UtBotsAtHome-UTFPR/bms_hestia/README.md

# BMSi-Hardware
Contains the hardware design of the BMSi board.

This is a work in progress, as development still being done.
No guarantee for functionality or safety! this design is experimental and tests are still being done.
The firmware is available in the main [BMSi](https://github.com/MrSerafim/BMSi) git.

This project requires soldering of many fine pitched parts including QFN.

### LICENSE NOTE: The root license applies to all subfolders NOT containing their own LICENSE file. If a subfolder contains a different LICENSE file this different license applies to all subfolders below this LICENSE file.

**If you want to sell any hardware of this project yourself i would kindly ask you to get in contact with me ([mail](mailto:luissouzaserafim@gmail.com))**
