UtBotsAtHome-UTFPR/bms_hestia/BMSi-Main/V2/README.md

### BMSi V2 board
This was the first released and working board.
