UtBotsAtHome-UTFPR/bms_hestia/BMSi-Main/V2/Board.png

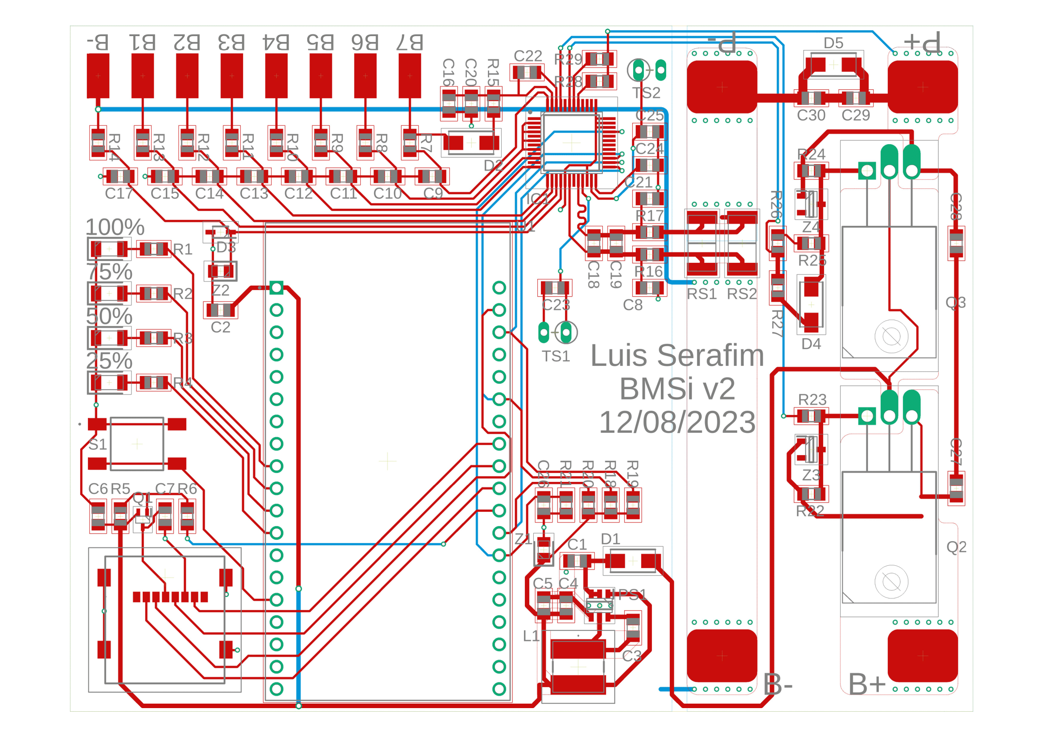
BMSi-Main/V2/Board.png
