UtBotsAtHome-UTFPR/bms_hestia/BMSi-Main/V2/BOM.xlsx

Sheet: BMSiv2
PRICE | Qty | TOTAL | Value | Package | Parts | Description | MANUFACTURER_NAME | MOUSER_PART_NUMBER | MOUSER_PRICE-STOCK
€0.021 | 8 | 0.17 € | 1/4W 20 OHM 1% | R0805 | R7, R8, R9, R10, R11, R12, R13, R14 | RESISTOR, European symbol |  |  | https://pt.mouser.com/ProductDetail/KOA-Speer/RK73H2ATTD20R0F?qs=sPP%252BYRfrDLyF2CjhOoVciw%3D%3D
€0.021 | 8 | 0.17 € | 1/4W 100 Ohms 1% | R0805 | R1, R2, R3, R4, R6, R15, R16, R17 | RESISTOR, European symbol |  |  | https://pt.mouser.com/ProductDetail/KOA-Speer/RK73H2ATTD1000F?qs=sfWGJbSe6PrSPN%2FbSWq5Cw%3D%3D
€0.021 | 4 | 0.08 € | 1/4W 5.1 kOhms 1% | R0805 | R23, R25, R26, R27 | RESISTOR, European symbol |  |  | https://pt.mouser.com/ProductDetail/KOA-Speer/RK73H2ATTD5101F?qs=qdbN2r920CXERR4aJasjig%3D%3D
€0.035 | 7 | 0.25 € | 1/4W 10 kOhms 1% | R0805 | R5, R18, R19, R20, R21, R28, R29 | RESISTOR, European symbol |  |  | https://pt.mouser.com/ProductDetail/KOA-Speer/RK73H2ATTDD1002F?qs=MxBfFmQCbB%252BkcQT2CtAwhQ%3D%3D
€0.035 | 2 | 0.07 € | 1/4W 10 Mohms 1% | R0805 | R22, R24 | RESISTOR, European symbol |  |  | https://pt.mouser.com/ProductDetail/KOA-Speer/RK73H2ATTDD1005F?qs=b4HQPcG6p0mmJwIGRp2kJQ%3D%3D
€0.055 | 2 | 0.11 € | 100 pF 10% 50V | C0805 | C18, C20 | CAPACITOR, European symbol | Kemet |  | https://pt.mouser.com/ProductDetail/KEMET/C0805C101K5GAC?qs=Zjfhvh7dXTMjTuwbhEzY2Q%3D%3D
€0.034 | 2 | 0.07 € | 470 pF 10% 50V | C0805 | C23, C25 | CAPACITOR, European symbol | Kemet |  | https://pt.mouser.com/ProductDetail/KEMET/C0805C471K5RACTU?qs=zLJ08xwufm6Yml9V9rLpFw%3D%3D
€0.023 | 10 | 0.23 € | 100 nF 10% 50V | C0805 | C3, C7, C8, C19, C21, C26, C27, C28, C29, C30 | CAPACITOR, European symbol | Kemet |  | https://pt.mouser.com/ProductDetail/Samsung-Electro-Mechanics/CL21B104KBCNFNC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
€0.032 | 8 | 0.26 € | 220 nF 10% 50V | C0805 | C9, C10, C11, C12, C13, C14, C15, C17 | CAPACITOR, European symbol | Kemet |  | https://pt.mouser.com/ProductDetail/Samsung-Electro-Mechanics/CL21B224KBFNFNE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
€0.055 | 1 | 0.06 € | 470 nF 10% 50V | C0805 | C22 | CAPACITOR, European symbol | Kemet |  | https://pt.mouser.com/ProductDetail/Samsung-Electro-Mechanics/CL21B474KBFNNNF?qs=yOVawPpwOwkFyCrUQsgTUg%3D%3D
€0.072 | 2 | 0.14 € | 1 uF 10% 50V | C0805 | C2, C16 | CAPACITOR, European symbol | Kemet |  | https://pt.mouser.com/ProductDetail/Samsung-Electro-Mechanics/CL21B105KBFNNNF?qs=349EhDEZ59rjtiyPmgVOOA%3D%3D
€0.145 | 1 | 0.14 € | 2.2 uF 10% 50V | C0805 | C24 | CAPACITOR, European symbol | Kemet |  | https://pt.mouser.com/ProductDetail/Samsung-Electro-Mechanics/CL21B225KBYNNNE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
€0.265 | 2 | 0.53 € | 10 uF 10% 50V | C0805 | C1, C6 | CAPACITOR, European symbol | Samsung |  | https://pt.mouser.com/ProductDetail/Samsung-Electro-Mechanics/CL21A106KBYQNNE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
€0.143 | 2 | 0.29 € | 22 uF 10% 16V | C0805 | C4, C5 | CAPACITOR, American symbol | Samsung |  | https://pt.mouser.com/ProductDetail/Samsung-Electro-Mechanics/CL21A226KOQNNNE?qs=AQlKX63v8RtLP39pX3WzzA%3D%3D
€0.801 | 1 | 0.80 € | AP63203WU-7 | SOT95P280X100-6N | PS1 | Switching Voltage Regulators DCDC Conv HV Buck TSOT26 T&R 3K | Diodes Inc. | 621-AP63203WU-7 | https://pt.mouser.com/ProductDetail/621-AP63203WU-7
€0.325 | 4 | 1.30 € | APT3216LVBC_D | LEDC3216X95N | LED1, LED2, LED3, LED4 | Standard LEDs - SMD 3.2X1.6MM LOW CRNT | Kingbright | 604-APT3216LVBCD | https://pt.mouser.com/ProductDetail/604-APT3216LVBCD
€0.306 | 1 | 0.31 € | BAT43WS-E3-08 | SOD2713X115N | D3 | Schottky Diodes & Rectifiers 30Volt 200mA 4A IFSM | Vishay | 78-BAT43WS-E3-08 | https://pt.mouser.com/ProductDetail/Vishay-Semiconductors/BAT43WS-E3-08?qs=KP8Io%2FXyE5T4LlUmkdvIAg%3D%3D
€0.144 | 2 | 0.29 € | BZX84-C16,215 | SOT95P230X110-3N | Z3, Z4 | Zener Diode 16 V 250 mW +/-5% Surface Mount TO-236AB | Nexperia | 771-BZX84-C16-T/R | https://pt.mouser.com/ProductDetail/771-BZX84-C16-T-R
€0.297 | 2 | 0.59 € | BZY55B3V6_RBG | DIOC2012X85N | Z1, Z2 | Zener Diodes 0805 500mW 2% Small Signal Zener Diode | Taiwan Semiconductor | 821-BZY55B3V6RBG | https://pt.mouser.com/ProductDetail/Taiwan-Semiconductor/BZY55B3V6-RBG?qs=mAH9sUMRCtv1hjtg7HbTxw%3D%3D
€0.189 | 4 | 0.76 € | S1B-13-F | DIONM5126X230N | D1, D2, D4, D5 | Diodes Inc S1B-13-F Switching Diode, 1A 100V, 2-Pin SMA | Diodes Inc. | 621-S1B-F | https://pt.mouser.com/ProductDetail/Diodes-Incorporated/S1B-13-F?qs=zxTnCqfIubBIimUkgF4o7A%3D%3D
€0.270 | 1 | 0.27 € | DMG1013T-7 | SOT50P160X90-3N | Q1 | MOSFET P-Channel 20V 0.46A SOT523 Diodes Inc DMG1013T-7 P-channel MOSFET Transistor, -0.46 A, -20 V, 3-Pin SOT-523 | Diodes Inc. | 621-DMG1013T-7 | https://pt.mouser.com/ProductDetail/621-DMG1013T-7
€1.640 | 2 | 3.28 € | IRFB3207PBF | TO220_HORIZONTAL | Q2, Q3 | MOSFET MOSFT 75V 180A 4.5mOhm 180nC |  |  | https://pt.mouser.com/ProductDetail/942-IRFB3207PBF
€0.567 | 2 | 1.13 € | PA2512FKE7W0R016E | RESC6432X88N | RS1, RS2 | 16 mOhms +/-1% 2W Chip Resistor 2512 (6432 Metric) Anti-Sulfur, Automotive AEC-Q200, Current Sense, Moisture Resistant Metal Element | YAGEO |  | https://pt.mouser.com/ProductDetail/603-PA2512FKE7W0R16E
€4.440 | 1 | 4.44 € | BQ76942PFBR | QFP50P900X900X120-48N | IC1 | Battery Management 3-series to 10-series multicell battery monitor and protector | Texas Instruments | 595-BQ76942PFBR | https://pt.mouser.com/ProductDetail/Texas-Instruments/BQ76942PFBR?qs=IS%252B4QmGtzzpmepW6RmrD8g%3D%3D
€1.040 | 1 | 1.04 € | MEM2067-02-180-00-A | MEM20670218000A | J1 | GCT (GLOBAL CONNECTOR TECHNOLOGY) - MEM2067-02-180-00-A - Memory Socket, MEM2067 Series, Memory Card, 8 Contacts, Copper Alloy, Gold Plated Contacts | GCT (GLOBAL CONNECTOR TECHNOLOGY) | 640-MEM20670218000A | https://pt.mouser.com/ProductDetail/640-MEM20670218000A
€0.288 | 1 | 0.29 € | FSM2JSMAATR | FSM2J_1 | S1 | Tactile switch,SMT,SPST | TE Connectivity | 506-FSM2JSMAATR | https://pt.mouser.com/ProductDetail/506-FSM2JSMAATR
€0.351 | 1 | 0.35 € | SRR5018-3R9Y | SRR50183R9Y | L1 | Power Inductors - SMD 3.9uH 30% SMD 5018 | Bourns | 652-SRR5018-3R9Y | https://pt.mouser.com/ProductDetail/652-SRR5018-3R9Y
€0.966 | 2 | 1.93 € | 103AT-2 | RS-2,5 | TS1, TS2 | THERMISTOR 103AT-2 10kOhm |  |  | https://pt.mouser.com/ProductDetail/954-103AT-2
€9.110 | 1 | 9.11 € | ESP32-DEVKITC-32D | ESP32-DEVKITC-32D | U1 | Esp32
Subtotal |  | 28.45 €
 |  | 1.59 € | PCB JLCPCB
Total |  | 30.04 €
Price values updated 12/08/2023

Sheet: Table
Componentes | Custo Unit. (€/Unid.) | Quant. (Unid.) | Preço (€) | Componentes | Custo Unit. (€/Unid.) | Quant. (Unid.) | Preço (€)
Resistores precisão SMD | 0.03 | 29 | 0.74 | ESP32-DEVKITC-32D | 9.11 | 1 | 9.11
Resistor Shunt 16 mOhm | 0.57 | 2 | 1.13 | Monitor Bateria - BQ76942 | 4.44 | 1 | 4.44
Capacitores cerâmicos SMD | 0.06 | 30 | 1.82 | MOSFET N - IRFB3207 | 1.64 | 2 | 3.28
Indutor 3.9uH SMD | 0.35 | 1 | 0.35 | MOSFET P - DMG1013T | 0.27 | 1 | 0.27
Thermistor 103AT-2 | 0.97 | 2 | 1.93 | Buck DC/DC - AP63203 | 0.80 | 1 | 0.80
Diodos SMD | 0.22 | 9 | 1.94 | Soquete microSD | 1.04 | 1 | 1.04
LEDs SMD | 0.33 | 4 | 1.30 | Botão Tactil SMD | 0.29 | 1 | 0.29
Fabricação PCB | 1.59 | 1 | 1.59
Total |  |  |  |  |  |  | 30.04
