UtBotsAtHome-UTFPR/bms_hestia/BMSi-Main/V2/Schematic.pdf

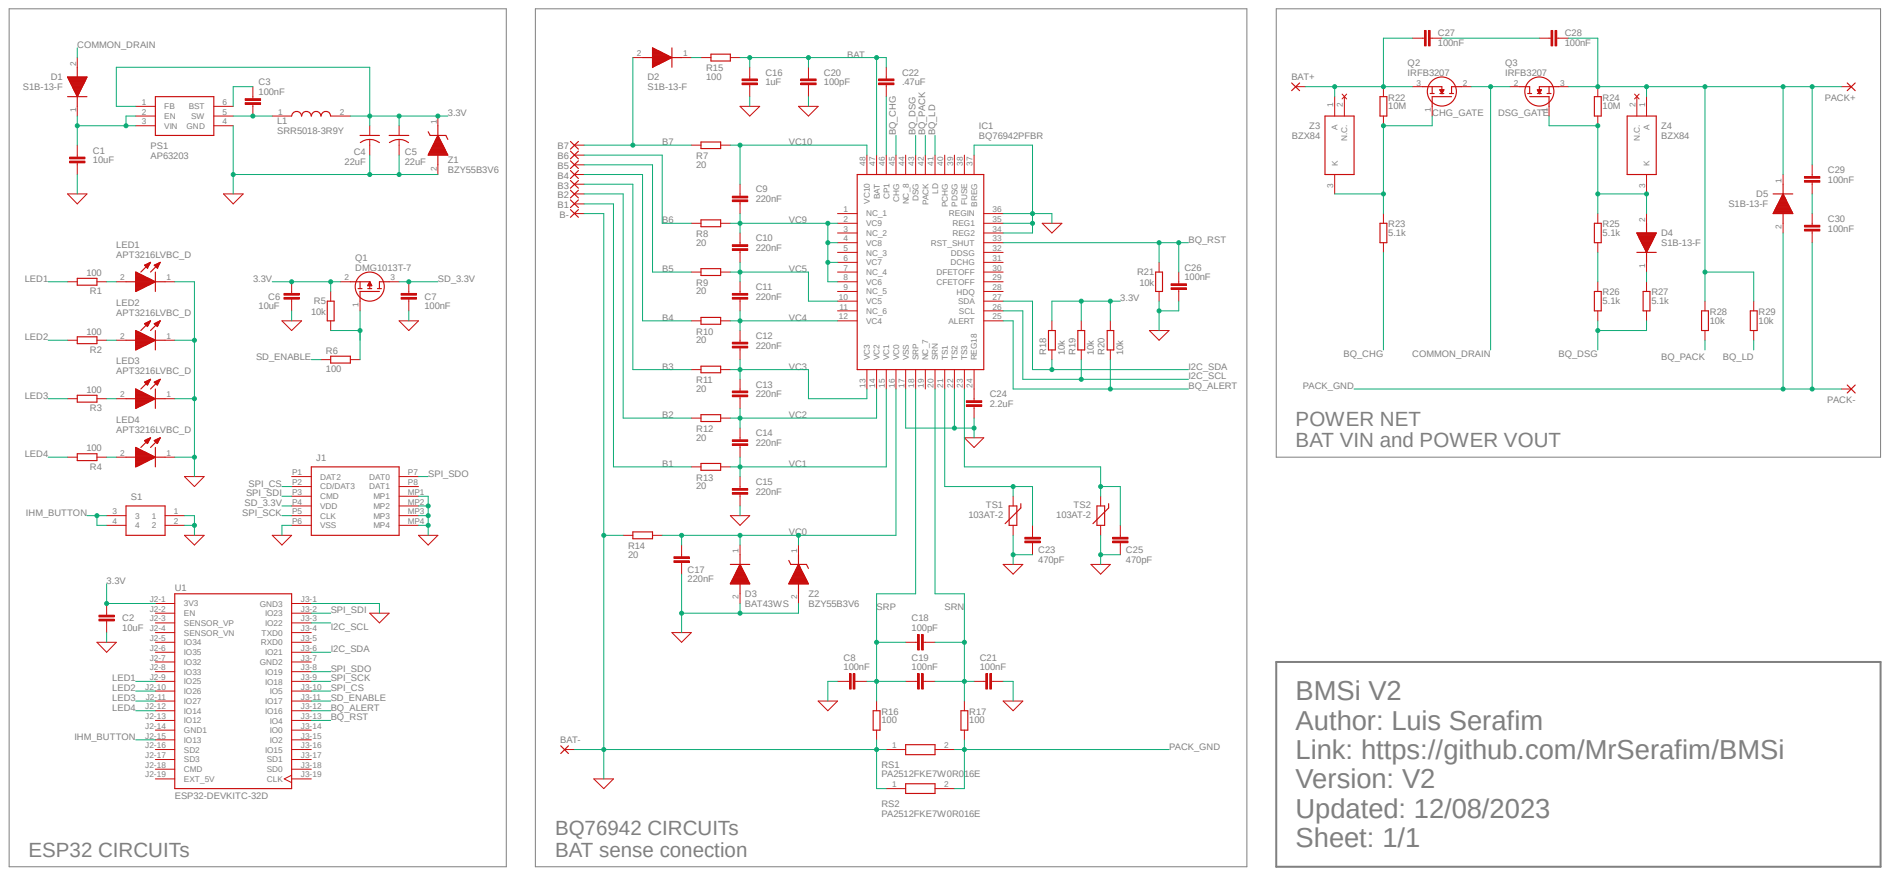
[picture p2: page 1]

PACK_GND
POWER NET
BAT VIN and POWER VOUT

BMSi V2
Author: Luis Serafim
Link: https://github.com/MrSerafim/BMSi
Version: V2
Updated: 12/08/2023
Sheet: 1/1
