UtBotsAtHome-UTFPR/bms_hestia/BMSi-Main/V2/SmartBMSv2.brd

## EAGLE design BMSi-Main/V2/SmartBMSv2.brd (2025-05-13)

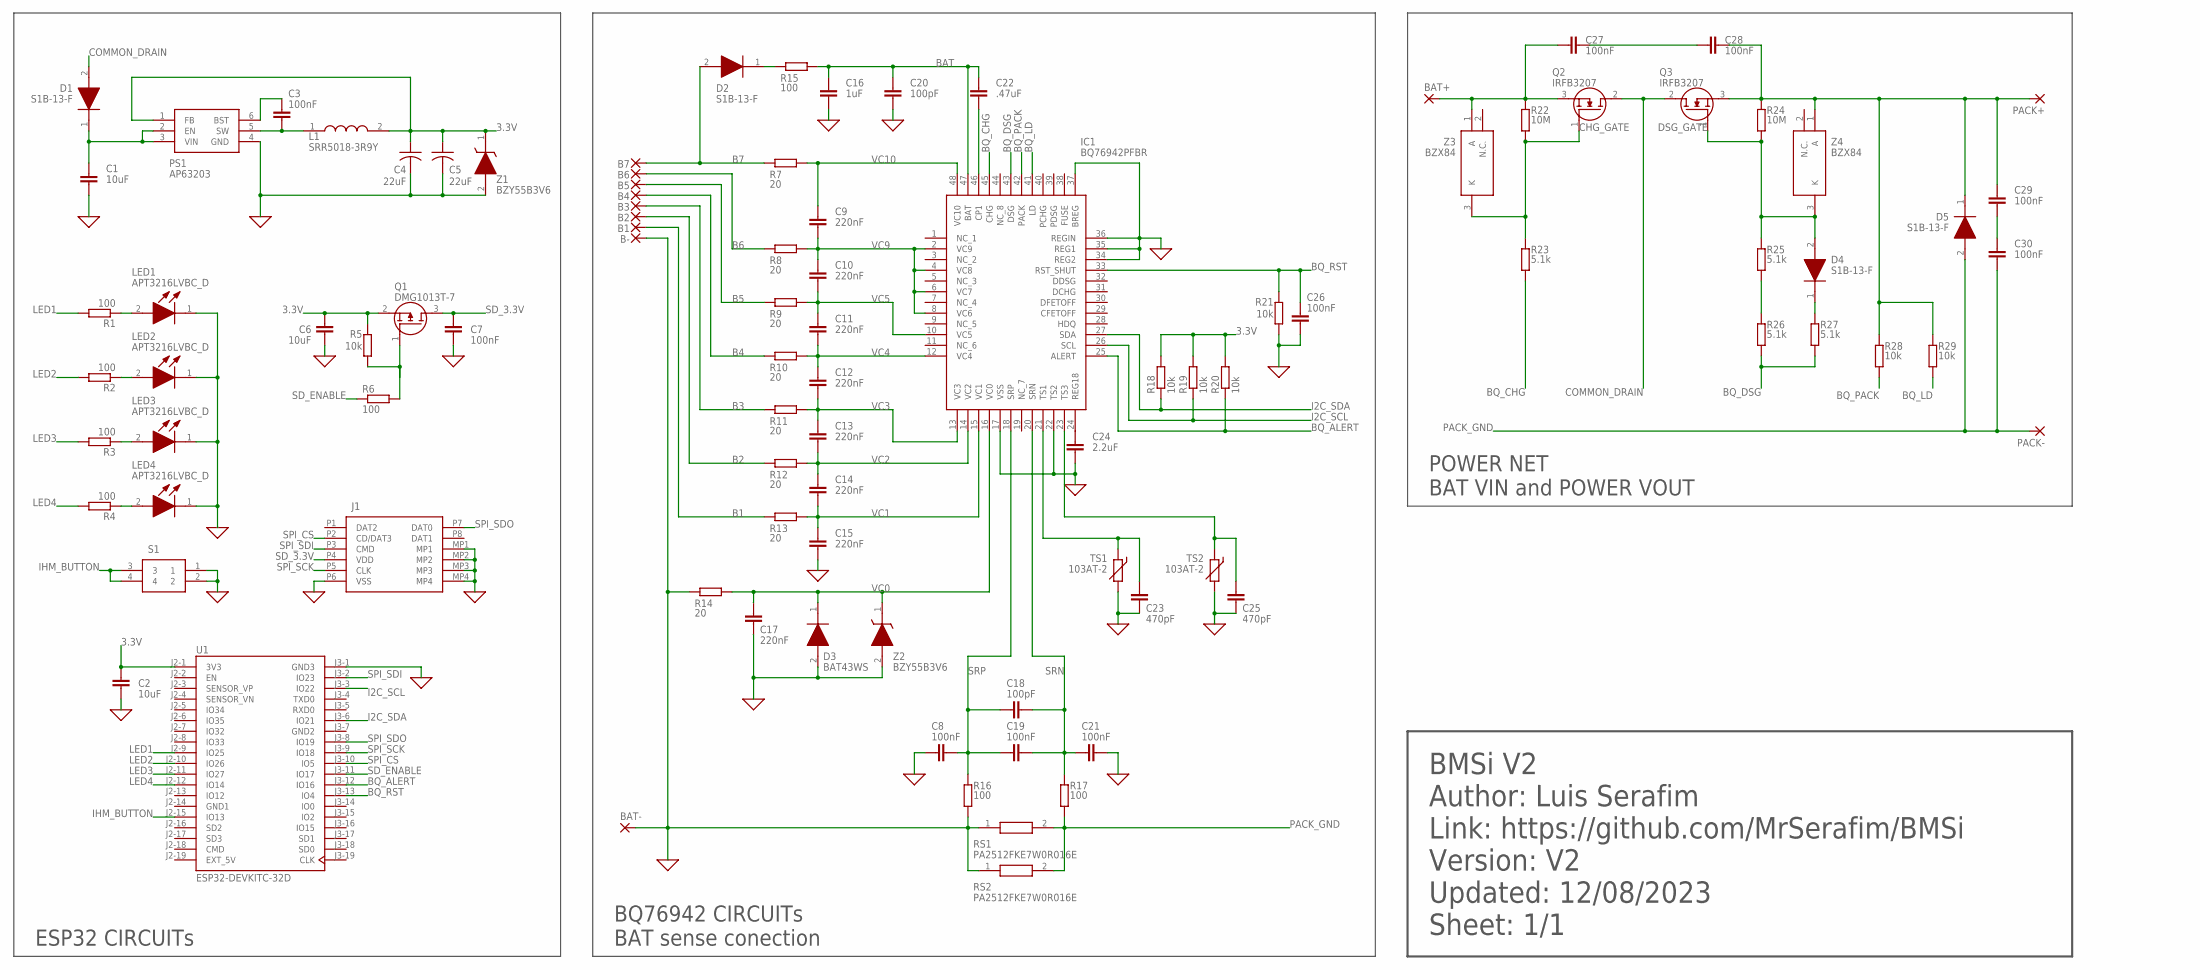
[picture p3: schematic SmartBMSv2.sch]

Parts:
B1, B2, B3, B4, B5, B6, B7: SMD5; SMD2,54-5,08
B-: SMD5; SMD2,54-5,08
BAT+: SMD5X10; SMD5-10
BAT-: SMD5X10; SMD5-10
C1, C2, C6: 10uF; C0805
C3, C7, C8, C19, C21, C26, C27, C28, C29, C30: 100nF; C0805
C4, C5: 22uF; C0805
C9, C10, C11, C12, C13, C14, C15, C17: 220nF; C0805
C16: 1uF; C0805
C18, C20: 100pF; C0805
C22: .47uF; C0805
C23, C25: 470pF; C0805
C24: 2.2uF; C0805
D1, D2, D4, D5: S1B-13-F; DIONM5126X230N
D3: BAT43WS; SOD2713X115N
IC1: BQ76942PFBR; QFP50P900X900X120-48N
J1: MEM2067-02-180-00-A; MEM20670218000A
L1: SRR5018-3R9Y; SRR50183R9Y
LED1, LED2, LED3, LED4: APT3216LVBC_D; LEDC3216X95N
PACK+: SMD5X10; SMD5-10
PACK-: SMD5X10; SMD5-10
PS1: AP63203; SOT95P280X100-6N
Q1: DMG1013T-7; SOT50P160X90-3N
Q2, Q3: IRFB3207; TO220_HORIZONTAL
R1, R2, R3, R4, R6, R15, R16, R17: 100; R0805
R5, R18, R19, R20, R21, R28, R29: 10k; R0805
R7, R8, R9, R10, R11, R12, R13, R14: 20; R0805
R22, R24: 10M; R0805
R23, R25, R26, R27: 5.1k; R0805
RS1, RS2: PA2512FKE7W0R016E; RESC6432X88N
S1: FSM2JSMAATR; FSM2J_1
TS1, TS2: 103AT-2; RS-2,5
U1: ESP32-DEVKITC-32D; MODULE_ESP32-DEVKITC-32D
Z1, Z2: BZY55B3V6; DIOC2012X85N
Z3, Z4: BZX84; SOT95P230X110-3N

Connections:
0: B-.1, BAT-.1, C1.2, C2.2, C4.2, C5.2, C6.1, C7.1, C8.1, C15.2, C16.2, C17.2, C20.2, C21.2, C23.2, C24.2, C25.2, C26.2, D3.2 (A), IC1.17 (VSS), IC1.22 (TS2), IC1.34 (REG2), IC1.35 (REG1), IC1.36 (REGIN), IC1.37 (BREG), J1.MP1, J1.MP2, J1.MP3, J1.MP4, J1.P6 (VSS), LED1.1 (K), LED2.1 (K), LED3.1 (K), LED4.1 (K), PS1.4 (GND), R14.1, R16.1, R21.1, RS1.1, RS2.1, S1.1, S1.2, TS1.2, TS2.2, U1.J3-1 (GND3), Z1.2 (A), Z2.2 (A)
3.3V: C2.1, C4.1, C5.1, C6.2, L1.2, PS1.1 (FB), Q1.2 (S), R5.2, R18.2, R19.2, R20.2, U1.J2-1 (3V3), Z1.1 (K)
B1: B1.1, R13.1
B2: B2.1, R12.1
B3: B3.1, R11.1
B4: B4.1, R10.1
B5: B5.1, R9.1
B6: B6.1, R8.1
B7: B7.1, D2.2 (A), R7.1
BAT: C16.1, C20.1, C22.1, IC1.47 (BAT), R15.2
BAT+: BAT+.1, C27.1, Q2.3 (S), R22.2, Z3.1 (A)
BQ_ALERT: IC1.25 (ALERT), R20.1, U1.J3-12 (IO16)
BQ_CHG: IC1.45 (CHG), R23.1
BQ_DSG: IC1.43 (DSG), R26.1, R27.1
BQ_LD: IC1.41 (LD), R29.2
BQ_PACK: IC1.42 (PACK), R28.2
BQ_RST: C26.1, IC1.33 (RST_SHUT), R21.2, U1.J3-13 (IO4)
CHG_GATE: Q2.1 (G), R22.1, R23.2, Z3.3 (K)
COMMON_DRAIN: D1.2 (A), Q2.2 (D), Q3.2 (D)
CP1: C22.2, IC1.46 (CP1)
D2_K: D2.1 (K), R15.1
DSG_DIODE_K: D4.1 (K), R27.2
DSG_GATE: D4.2 (A), Q3.1 (G), R24.1, R25.2, Z4.3 (K)
DSG_RES: R25.1, R26.2
EXT_5V: U1.J2-19 (EXT_5V)
FET_ESDP: C27.2, C28.1
GND1: U1.J2-14 (GND1)
GND2: U1.J3-7 (GND2)
I2C_SCL: IC1.26 (SCL), R19.1, U1.J3-3 (IO22)
I2C_SDA: IC1.27 (SDA), R18.1, U1.J3-6 (IO21)
IHM_BUTTON: S1.3, S1.4, U1.J2-15 (IO13)
LED1: R1.2, U1.J2-9 (IO25)
LED1_ANODE: LED1.2 (A), R1.1
LED2: R2.2, U1.J2-10 (IO26)
LED2_ANODE: LED2.2 (A), R2.1
LED3: R3.2, U1.J2-11 (IO27)
LED3_ANODE: LED3.2 (A), R3.1
LED4: R4.2, U1.J2-12 (IO14)
LED4_ANODE: LED4.2 (A), R4.1
PACK+: C28.2, C29.1, D5.1 (K), PACK+.1, Q3.3 (S), R24.2, R28.1, R29.1, Z4.1 (A)
PACK_ESDP: C29.2, C30.1
PACK_GND: C30.2, D5.2 (A), PACK-.1, R17.1, RS1.2, RS2.2
PS1_BST: C3.2, PS1.6 (BST)
PS1_SW: C3.1, L1.1, PS1.5 (SW)
PS_VIN: C1.1, D1.1 (K), PS1.2 (EN), PS1.3 (VIN)
Q1_GATE: Q1.1 (G), R5.1, R6.2
REG18: C24.1, IC1.24 (REG18)
SD_3.3V: C7.2, J1.P4 (VDD), Q1.3 (D)
SD_ENABLE: R6.1, U1.J3-11 (IO17)
SPI_CS: J1.P2 (CD/DAT3), U1.J3-10 (IO5)
SPI_SCK: J1.P5 (CLK), U1.J3-9 (IO18)
SPI_SDI: J1.P3 (CMD), U1.J3-2 (IO23)
SPI_SDO: J1.P7 (DAT0), U1.J3-8 (IO19)
SRN: C18.2, C19.2, C21.1, IC1.20 (SRN), R17.2
SRP: C8.2, C18.1, C19.1, IC1.18 (SRP), R16.2
TS1: C23.1, IC1.21 (TS1), TS1.1
TS3: C25.1, IC1.23 (TS3), TS2.1
VC0: C17.1, D3.1 (K), IC1.16 (VC0), R14.2, Z2.1 (K)
VC1: C14.2, C15.1, IC1.15 (VC1), R13.2
VC2: C13.2, C14.1, IC1.14 (VC2), R12.2
VC3: C12.2, C13.1, IC1.13 (VC3), R11.2
VC4: C11.2, C12.1, IC1.12 (VC4), R10.2
VC5: C10.2, C11.1, IC1.10 (VC5), R9.2
VC9: C9.2, C10.1, IC1.2 (VC9), IC1.4 (VC8), IC1.6 (VC7), IC1.8 (VC6), R8.2
VC10: C9.1, IC1.48 (VC10), R7.2

Notes on the sheet:
POWER NET BAT VIN and POWER VOUT
BQ76942 CIRCUITs BAT sense conection
ESP32 CIRCUITs
BMSi V2 Author: Luis Serafim Link: https://github.com/MrSerafim/BMSi Version: V2 Updated: 12/08/2023 Sheet: 1/1

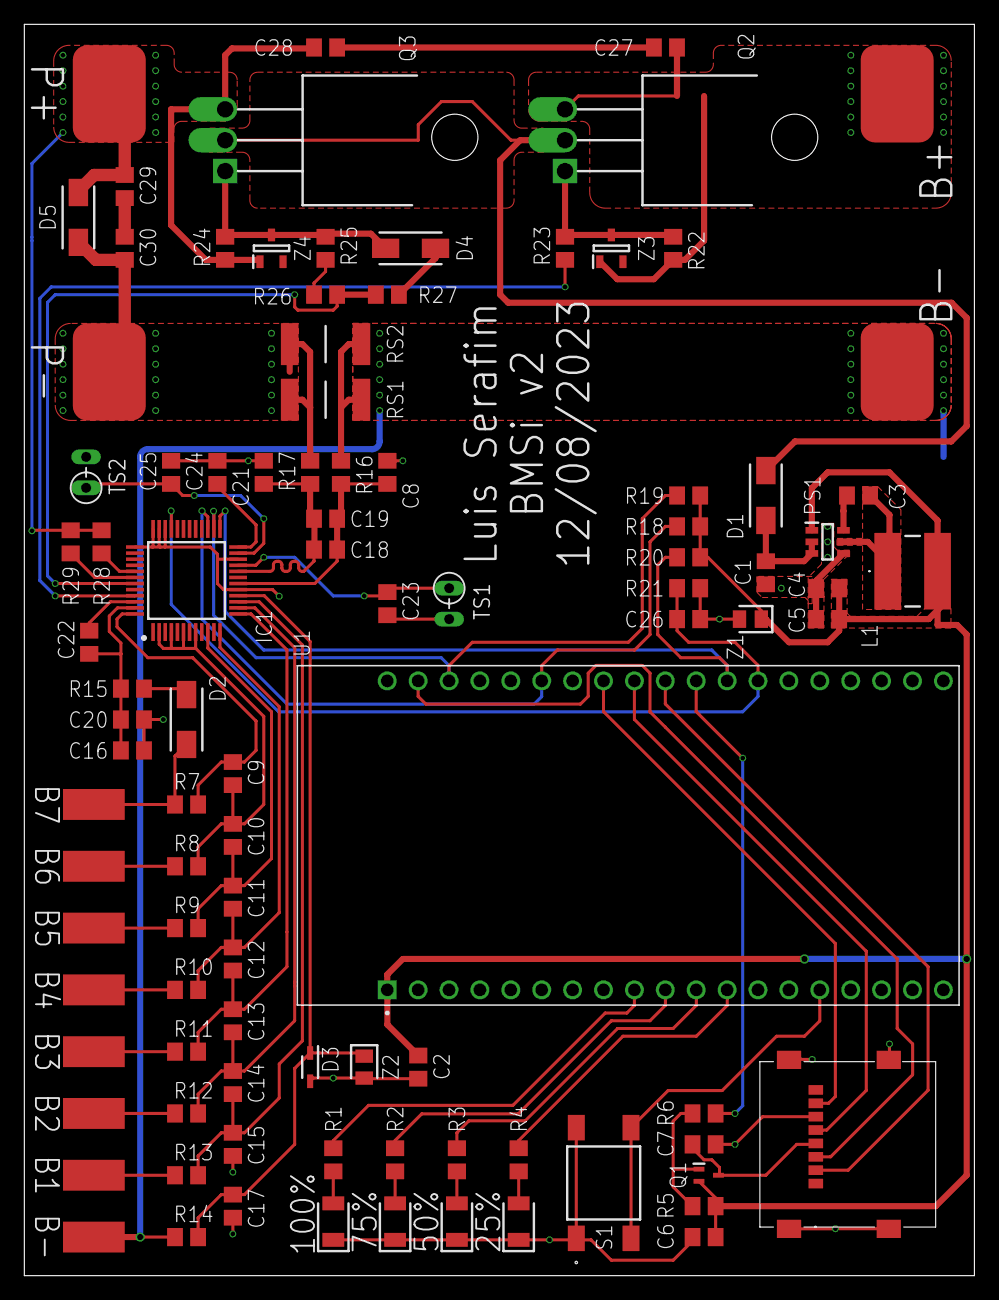
[picture p4: board SmartBMSv2.brd from above]

Board: 2 copper layers, 78.1 x 102.9 mm, 97 parts (0 on the bottom side), 62 nets.
